adafruit/Adafruit-Metro-ESP32-P4-Hydra-PCB/factory-reset/README.md

# Coming soon - documentation in progress

## Factory Reset file - Metro ESP32-P4 Hydra - with 16 MB PSRAM - v1 Chipset

This is the factory reset file for the Metro ESP32-P4 Hydra - with 16 MB PSRAM - v1 Chipset.
