adafruit/Adafruit-Metro-ESP32-P4-Hydra-PCB/Adafruit_Metro_ESP32-P4_PrettyPins.pdf

## Power GND

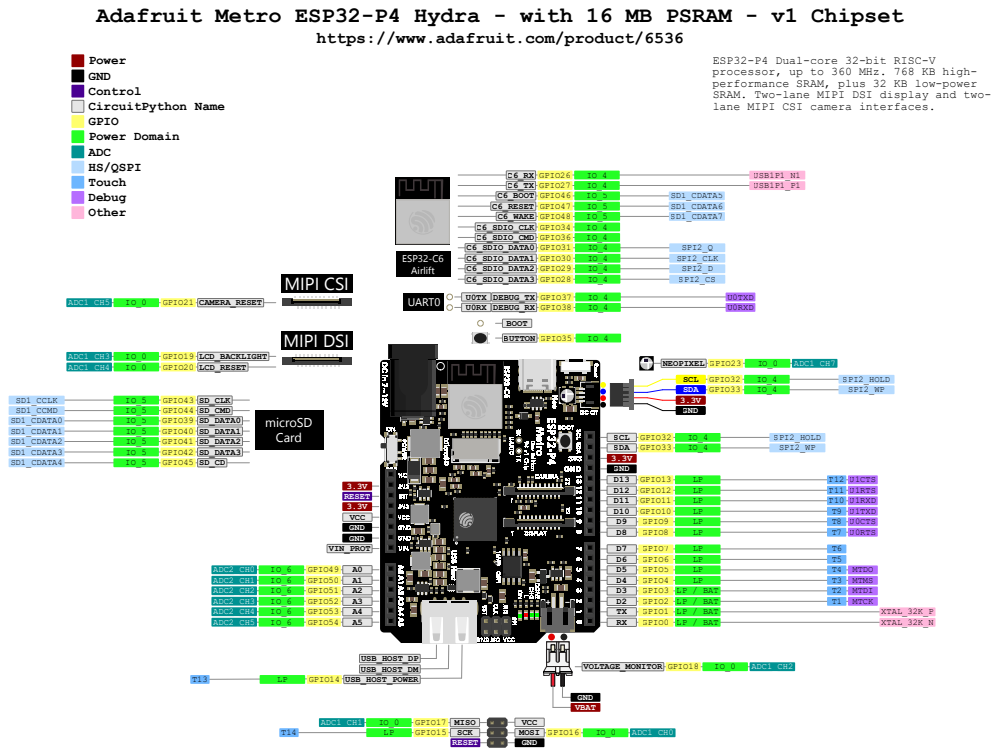
[picture p2: page 1]

Adafruit Metro ESP32-P4 Hydra - with 16 MB PSRAM - v1 Chipset

https://www.adafruit.com/product/6536

ESP32-P4 Dual-core 32-bit RISC-V
processor, up to 360 MHz. 768 KB high-
performance SRAM, plus 32 KB low-power
SRAM. Two-lane MIPI DSI display and two-
lane MIPI CSI camera interfaces.
