adafruit/Adafruit-Metro-ESP32-P4-Hydra-PCB/Adafruit Metro ESP32-P4 Hydra rev A.brd

## EAGLE design Adafruit Metro ESP32-P4 Hydra rev A.brd (2026-10-26)

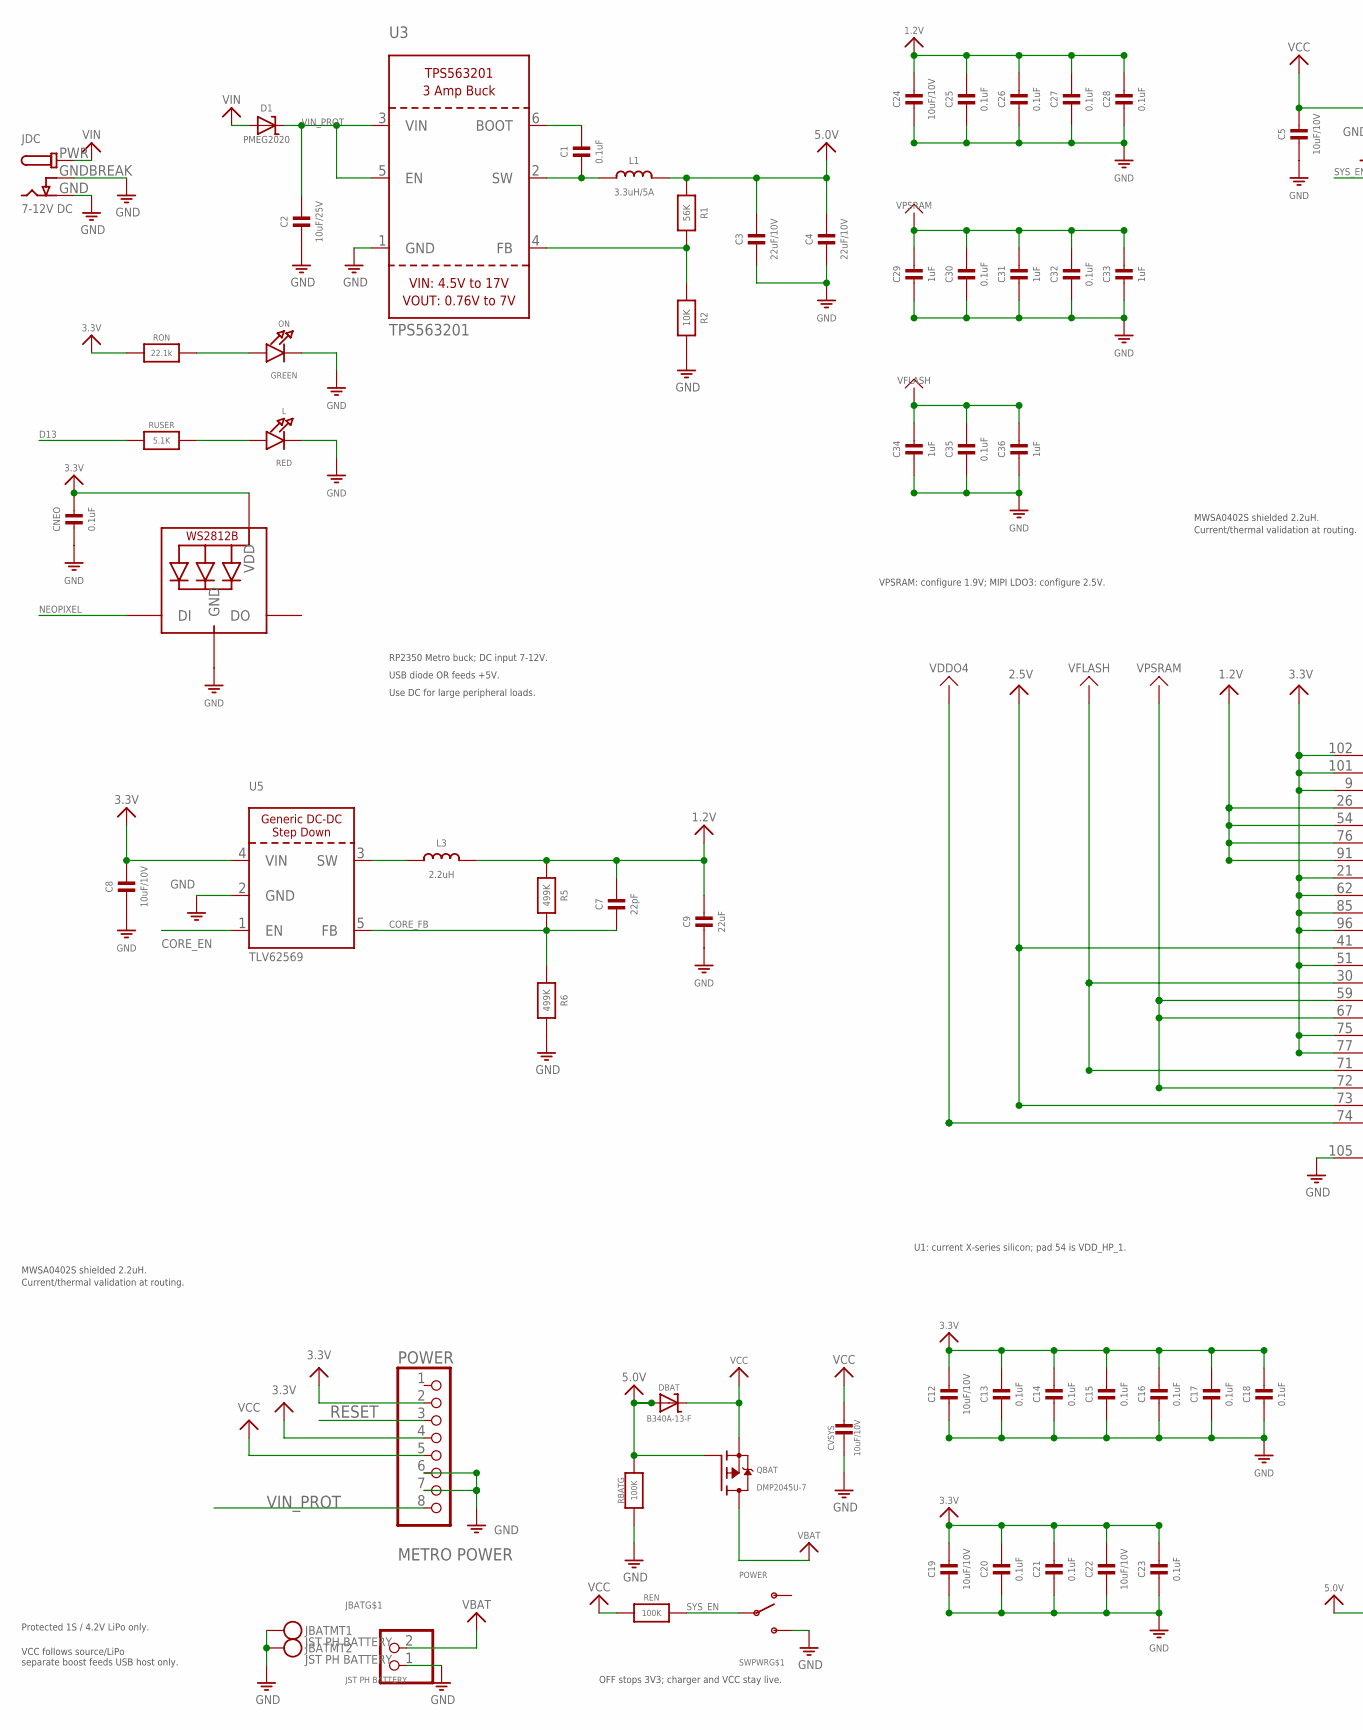
[picture p3: schematic Adafruit Metro ESP32-P4 Hydra rev A.sch, sheet 1, part in row 1, column 1]

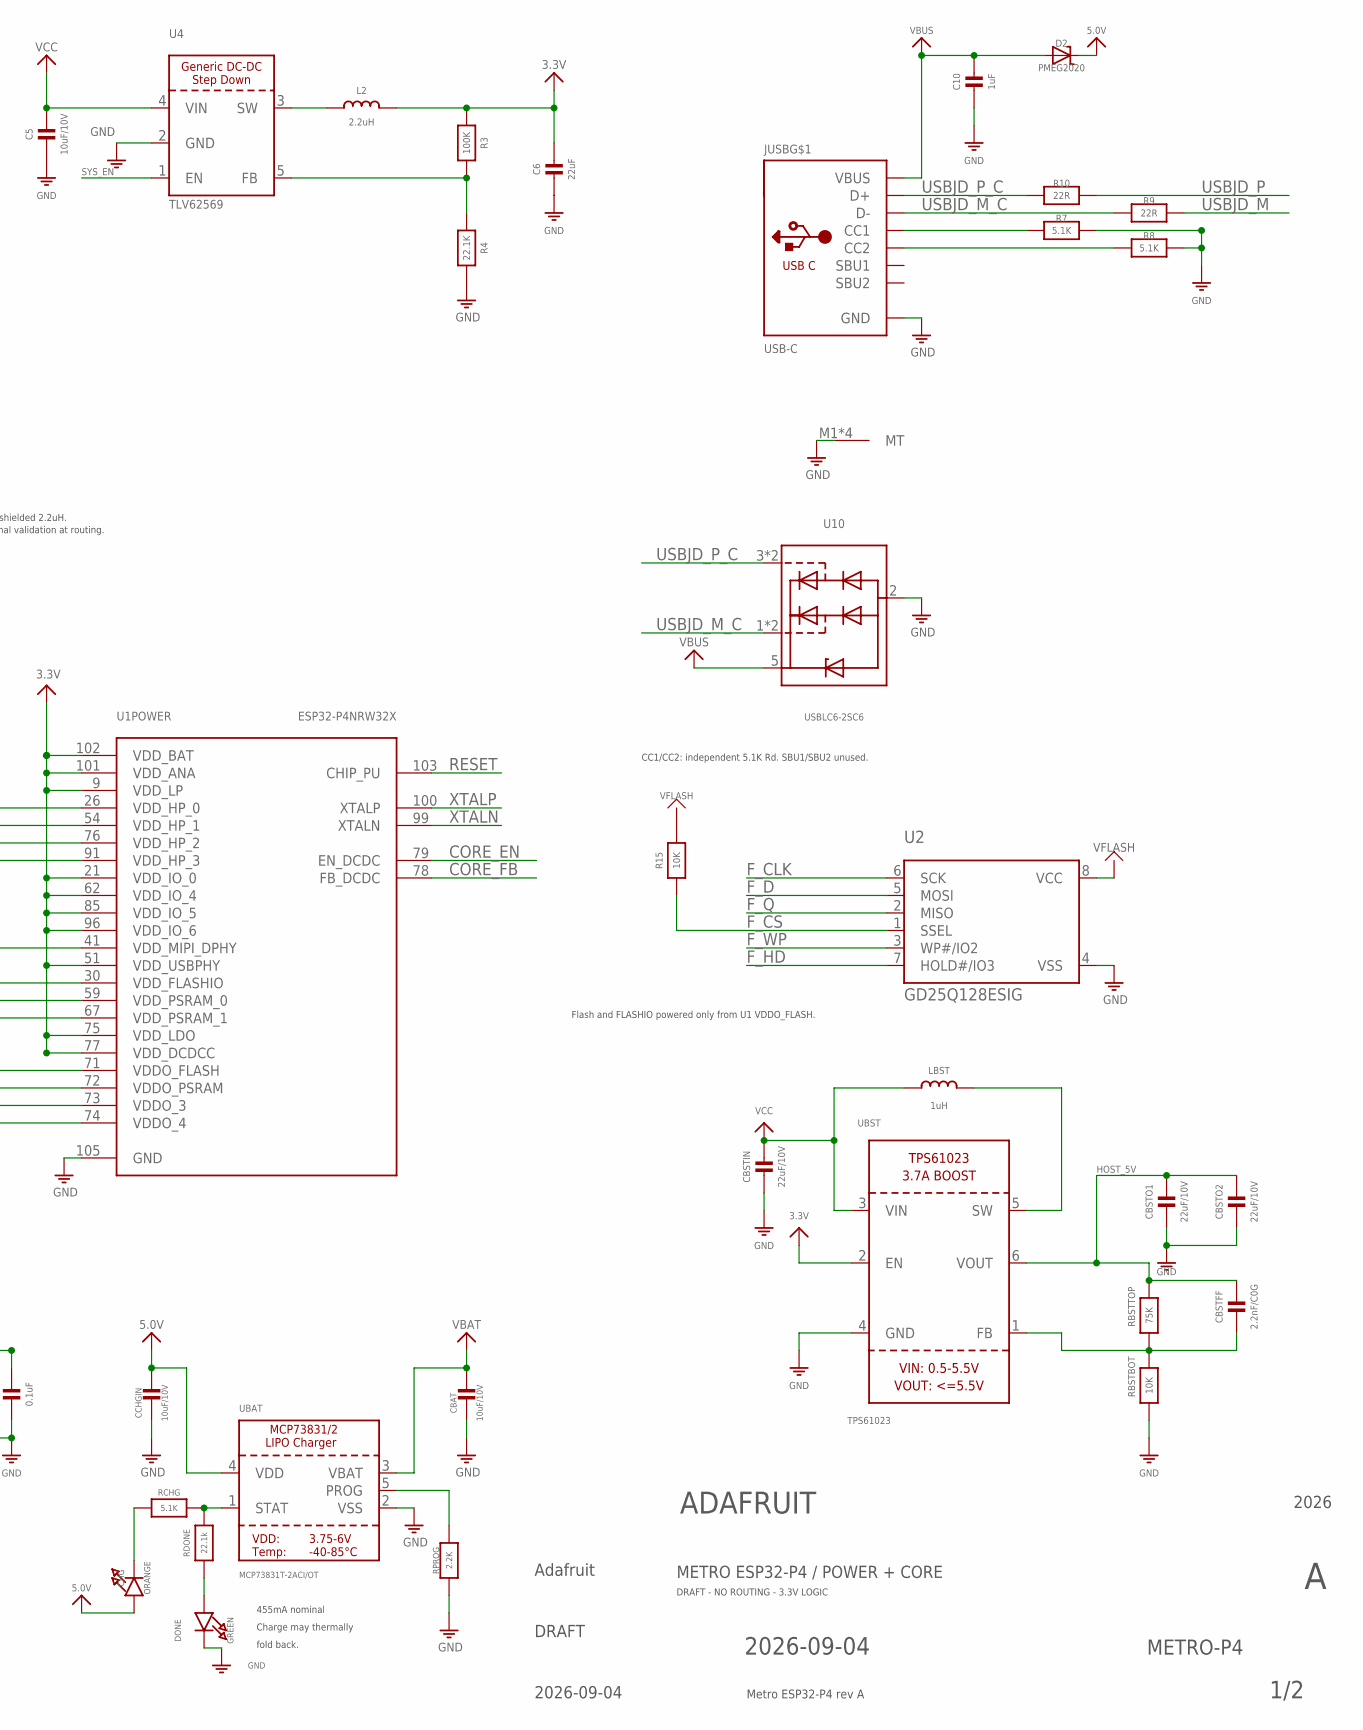
[picture p4: schematic Adafruit Metro ESP32-P4 Hydra rev A.sch, sheet 1, part in row 1, column 2]

Parts:
C1, C13, C14, C15, C16, C17, C18, C20, C21, C23, C25, C26, C27, C28, C30, C32, C35: 0.1uF; _0402NO
C2: 10uF/25V; 0805-NO
C3, C4: 22uF/10V; 0805-NO
C5, C8, C12, C19, C22, C24: 10uF/10V; 0805-NO
C6, C9: 22uF; 0805-NO
C7: 22pF; _0402NO
C10, C29, C31, C33, C34, C36: 1uF; 0603-NO
CBAT: 10uF/10V; 0805-NO
CBSTFF: 2.2nF/C0G; _0402NO; MPN GRM1555C1H222GA01D; LCSC C2987940
CBSTIN: 22uF/10V; 0805-NO; MPN CL21A226MPQNNNE; LCSC C29277
CBSTO1, CBSTO2: 22uF/10V; 0805-NO; MPN CL21A226MPQNNNE; LCSC C29277
CCHGIN: 10uF/10V; 0805-NO
CHG: ORANGE; CHIPLED_0603_NOOUTLINE
CNEO: 0.1uF; _0402NO
CVSYS: 10uF/10V; 0805-NO
D1, D2: PMEG2020; SOD-323
DBAT: B340A-13-F; SMADIODE; MPN B340A-13-F
DONE: GREEN; CHIPLED_0603_NOOUTLINE
HYDRA_ART: METRO-P4-HYDRA; METRO-P4-HYDRA-68.58X53.34
JBAT: JST PH BATTERY; JSTPH2_BATT
JDC: 7-12V DC; DCJACK_2MM_PTH
JUSB: USB-C; USB_C_CUSB31-CFM2AX-01-X
L: RED; CHIPLED_0603_NOOUTLINE
L1: 3.3uH/5A; INDUCTOR_0603S
L2, L3: 2.2uH; INDUCTOR_SUNLORD_MWSA0402S; MPN MWSA0402S-2R2MT; LCSC C408335
LBST: 1uH; INDUCTOR_5045_SMALLTABS
LED1: WS2812B_3535FULL; LED3535_FULLPADS
ON: GREEN; CHIPLED_0603_NOOUTLINE
POWER: METRO POWER; 1X08_OVALWAVE
QBAT: DMP2045U-7; SOT23-R; MPN DMP2045U-7
R1: 56K; _0402NO
R2, R15: 10K; _0402NO
R3: 100K; _0402NO
R4: 22.1K; _0402NO
R5, R6: 499K; _0402NO
R7, R8: 5.1K; _0402NO
R9, R10: 22R; _0402NO
RBATG: 100K; _0402NO
RBSTBOT: 10K; _0402NO
RBSTTOP: 75K; _0402NO
RCHG: 5.1K; _0402NO
RDONE: 22.1k; _0402NO
REN: 100K; _0402NO
RON: 22.1k; _0402NO
RPROG: 2.2K; _0402NO
RUSER: 5.1K; _0402NO
SWPWR: POWER; SPDT_SMT_SSSS811101
U1: ESP32-P4NRW32X; QFN104_10X10_P035_EP76; MPN ESP32-P4NRW32X; LCSC C9900140808
U2: GD25Q128ESIG; SOIC8_208MIL; MPN GD25Q128ESIG
U3: TPS563201; SOT23-6; MPN TPS563201DDCR
U4, U5: TLV62569; SOT23-5; MPN TLV62569DBVR
U10: USBLC6-2SC6; SOT23_6L_ST
UBAT: MCP73831T-2ACI/OT; SOT23-5
UBST: TPS61023; SOT563; MPN TPS61023DRLR; LCSC C919459

Connections:
1.2V: C7.1, C9.1, C24.1, C25.1, C26.1, C27.1, C28.1, L3.P$2 (2), R5.1, U1.26 (VDD_HP_0), U1.54 (VDD_HP_1), U1.76 (VDD_HP_2), U1.91 (VDD_HP_3)
2.5V: U1.41 (VDD_MIPI_DPHY), U1.73 (VDDO_3); also elsewhere on the board
3.3V: C6.1, C8.1, C12.1, C13.1, C14.1, C15.1, C16.1, C17.1, C18.1, C19.1, C20.1, C21.1, C22.1, C23.1, CNEO.1, L2.P$2 (2), LED1.2 (VDD), POWER.2, POWER.4, R3.1, RON.1, U1.9 (VDD_LP), U1.21 (VDD_IO_0), U1.51 (VDD_USBPHY), U1.62 (VDD_IO_4), U1.75 (VDD_LDO), U1.77 (VDD_DCDCC), U1.85 (VDD_IO_5), U1.96 (VDD_IO_6), U1.101 (VDD_ANA), U1.102 (VDD_BAT), U5.4 (VIN), UBST.2 (EN); also elsewhere on the board
5.0V: C3.1, C4.1, CCHGIN.1, CHG.A, D2.C, DBAT.A, L1.P$2 (2), QBAT.1 (G), R1.1, RBATG.1, UBAT.4 (VDD)
BAT_LED: CHG.C, RCHG.1
BAT_PROG: RPROG.1, UBAT.5 (PROG)
BAT_STAT: RCHG.2, RDONE.1, UBAT.1 (STAT)
BST_FB: CBSTFF.2, RBSTBOT.1, RBSTTOP.2, UBST.1 (FB)
BST_SW: LBST.2, UBST.5 (SW)
BUCK5_BST: C1.1, U3.6 (BOOT)
BUCK5_FB: R1.2, R2.1, U3.4 (FB)
BUCK5_SW: C1.2, L1.P$1 (1), U3.2 (SW)
CORE_EN: U1.79 (EN_DCDC), U5.1 (EN)
CORE_FB: C7.2, R5.2, R6.1, U1.78 (FB_DCDC), U5.5 (FB)
D13: RUSER.1; also elsewhere on the board
DONE_LED: DONE.A, RDONE.2
F_CLK: U2.6 (SCK); also elsewhere on the board
F_CS: R15.2, U2.1 (SSEL); also elsewhere on the board
F_D: U2.5 (MOSI); also elsewhere on the board
F_HD: U2.7 (HOLD#/IO3); also elsewhere on the board
F_Q: U2.2 (MISO); also elsewhere on the board
F_WP: U2.3 (WP#/IO2); also elsewhere on the board
GND: C2.2, C3.2, C4.2, C5.2, C6.2, C8.2, C9.2, C10.2, C12.2, C13.2, C14.2, C15.2, C16.2, C17.2, C18.2, C19.2, C20.2, C21.2, C22.2, C23.2, C24.2, C25.2, C26.2, C27.2, C28.2, C29.2, C30.2, C31.2, C32.2, C33.2, C34.2, C35.2, C36.2, CBAT.2, CBSTIN.2, CBSTO1.2, CBSTO2.2, CCHGIN.2, CNEO.2, CVSYS.2, DONE.C, JBAT.1, JBAT.NC1, JBAT.NC2, JDC.GND, JDC.GNDBREAK, JUSB.A1B12 (GND), JUSB.B1A12 (GND), JUSB.M1 (MT), JUSB.M2 (MT), JUSB.M3 (MT), JUSB.M4 (MT), L.C, LED1.4 (GND), ON.C, POWER.6, POWER.7, R2.2, R4.2, R6.2, R7.2, R8.2, RBATG.2, RBSTBOT.2, RPROG.2, SWPWR.C (S), U1.105 (GND), U2.4 (VSS), U3.1 (GND), U4.2 (GND), U5.2 (GND), U10.2 (GND), UBAT.2 (VSS), UBST.4 (GND); also elsewhere on the board
HOST_5V: CBSTFF.1, CBSTO1.1, CBSTO2.1, RBSTTOP.1, UBST.6 (VOUT); also elsewhere on the board
JUSBCC1: JUSB.A5 (CC1), R7.1
JUSBCC2: JUSB.B5 (CC2), R8.1
LED_ON: ON.A, RON.2
LED_USER: L.A, RUSER.2
NEOPIXEL: LED1.1 (DI); also elsewhere on the board
RESET: POWER.3, U1.103 (CHIP_PU); also elsewhere on the board
SYS_EN: REN.2, SWPWR.B, U4.1 (EN)
U4_FB: R3.2, R4.1, U4.5 (FB)
U4_SW: L2.P$1 (1), U4.3 (SW)
U5_SW: L3.P$1 (1), U5.3 (SW)
USBJD_M: R9.2; also elsewhere on the board
USBJD_M_C: JUSB.A7 (D-), JUSB.B7 (D-), R9.1, U10.1 (IO1), U10.6 (IO1)
USBJD_P: R10.2; also elsewhere on the board
USBJD_P_C: JUSB.A6 (D+), JUSB.B6 (D+), R10.1, U10.3 (IO2), U10.4 (IO2)
VBAT: CBAT.1, JBAT.2, QBAT.3 (D), UBAT.3 (VBAT); also elsewhere on the board
VBUS: C10.1, D2.A, JUSB.A4B9 (VBUS), JUSB.B4A9 (VBUS), U10.5 (VCC)
VCC: C5.1, CBSTIN.1, CVSYS.1, DBAT.C, LBST.1, POWER.5, QBAT.2 (S), REN.1, U4.4 (VIN), UBST.3 (VIN); also elsewhere on the board
VDDO4: U1.74 (VDDO_4); also elsewhere on the board
VFLASH: C34.1, C35.1, C36.1, R15.1, U1.30 (VDD_FLASHIO), U1.71 (VDDO_FLASH), U2.8 (VCC)
VIN: D1.A, JDC.PWR
VIN_PROT: C2.1, D1.C, POWER.8, U3.3 (VIN), U3.5 (EN)
VPSRAM: C29.1, C30.1, C31.1, C32.1, C33.1, U1.59 (VDD_PSRAM_0), U1.67 (VDD_PSRAM_1), U1.72 (VDDO_PSRAM)
XTALN: U1.99 (XTALN); also elsewhere on the board
XTALP: U1.100 (XTALP); also elsewhere on the board

Notes on the sheet:
1/2
Metro ESP32-P4 rev A
2026-09-04
2026
ADAFRUIT
Adafruit
DRAFT
METRO-P4
METRO ESP32-P4 / POWER + CORE
DRAFT - NO ROUTING - 3.3V LOGIC
RP2350 Metro buck; DC input 7-12V.
USB diode OR feeds +5V.
MWSA0402S shielded 2.2uH.
Current/thermal validation at routing.
CC1/CC2: independent 5.1K Rd. SBU1/SBU2 unused.
U1: current X-series silicon; pad 54 is VDD_HP_1.
VPSRAM: configure 1.9V; MIPI LDO3: configure 2.5V.
Flash and FLASHIO powered only from U1 VDDO_FLASH.
455mA nominal
OFF stops 3V3; charger and VCC stay live.
Protected 1S / 4.2V LiPo only.
VCC follows source/LiPo separate boost feeds USB host only.
Use DC for large peripheral loads.
Charge may thermally
fold back.

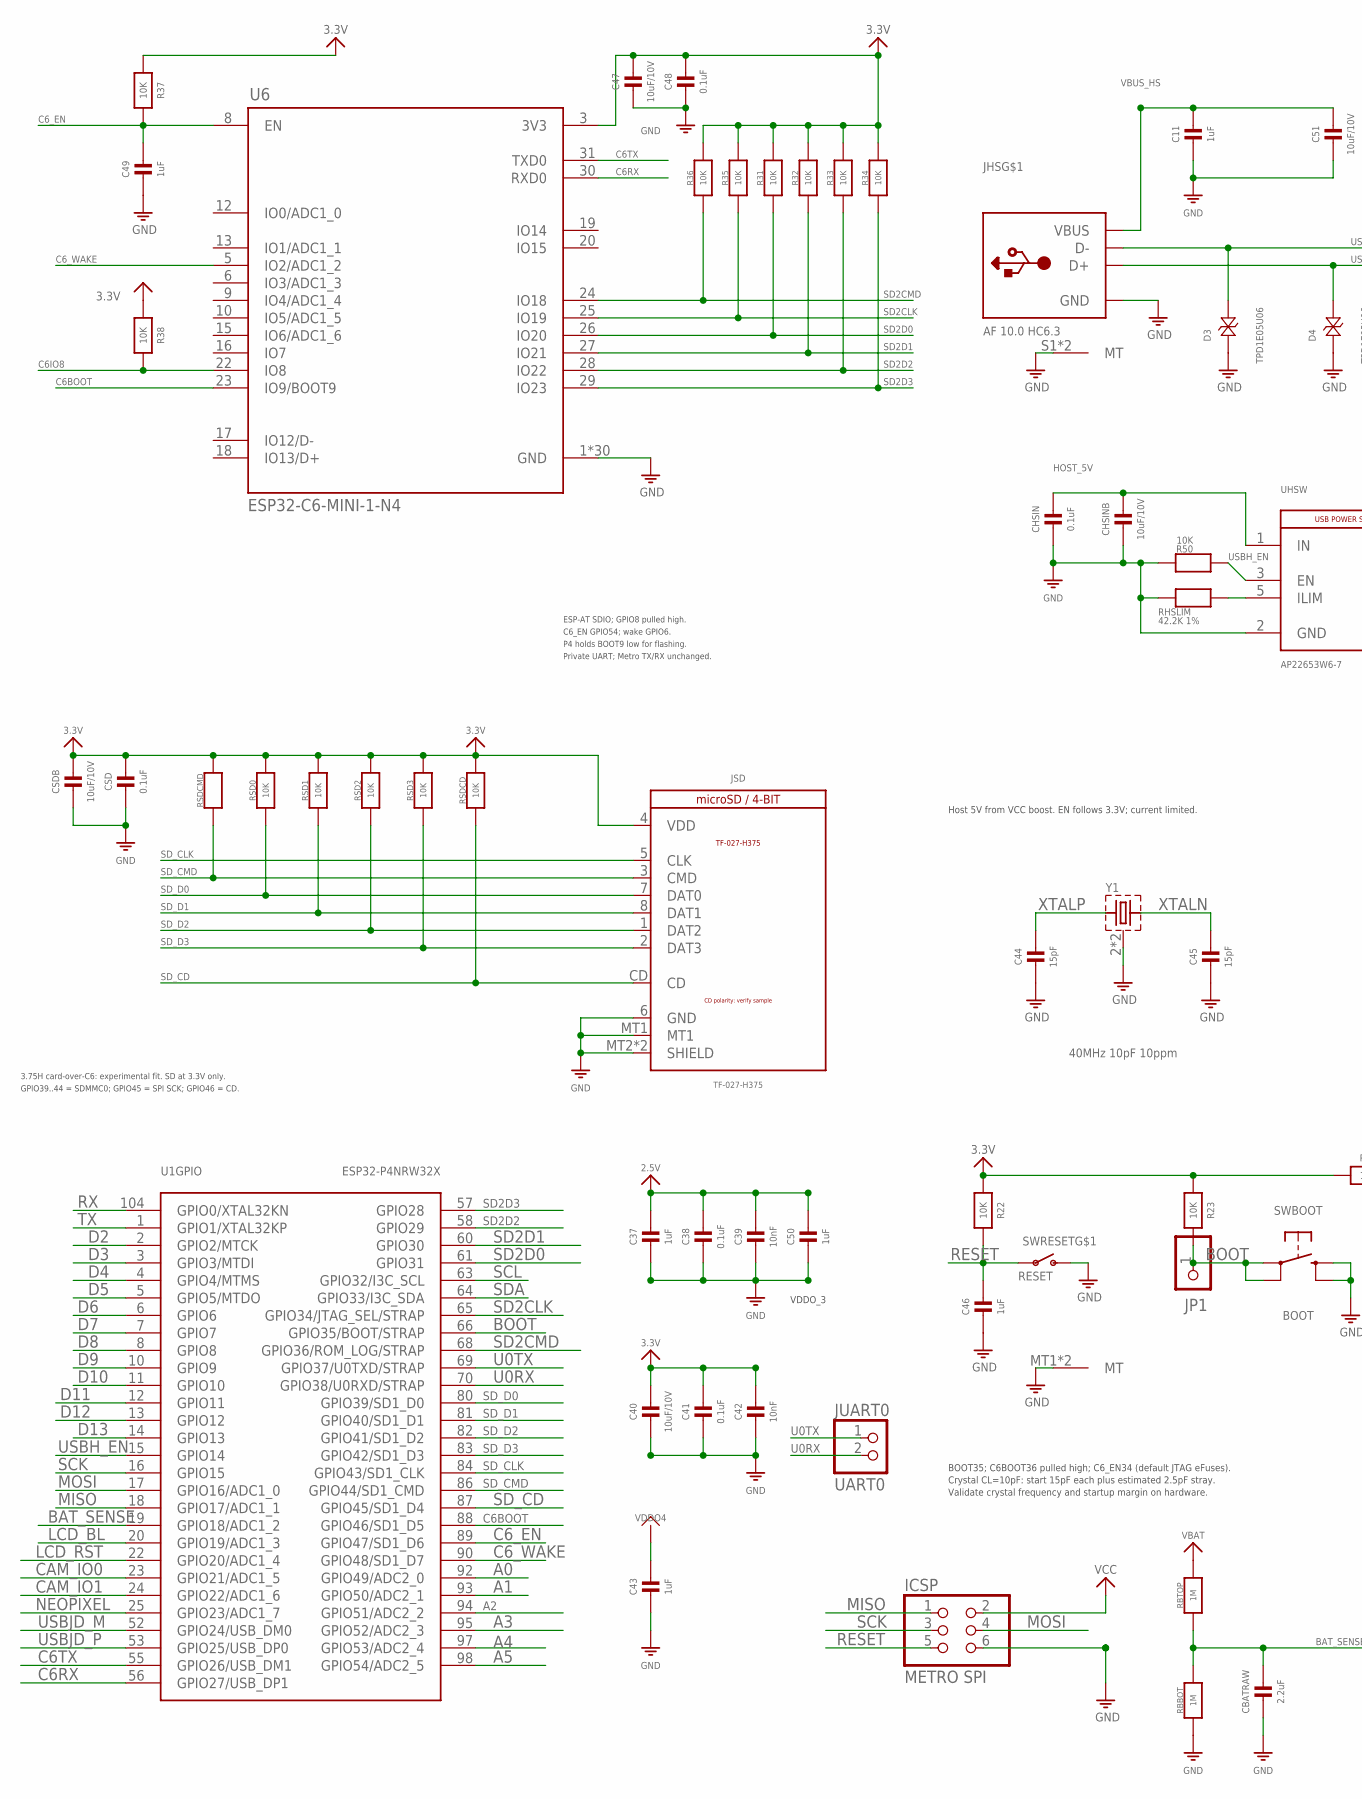
[picture p5: schematic Adafruit Metro ESP32-P4 Hydra rev A.sch, sheet 2, part in row 1, column 1]

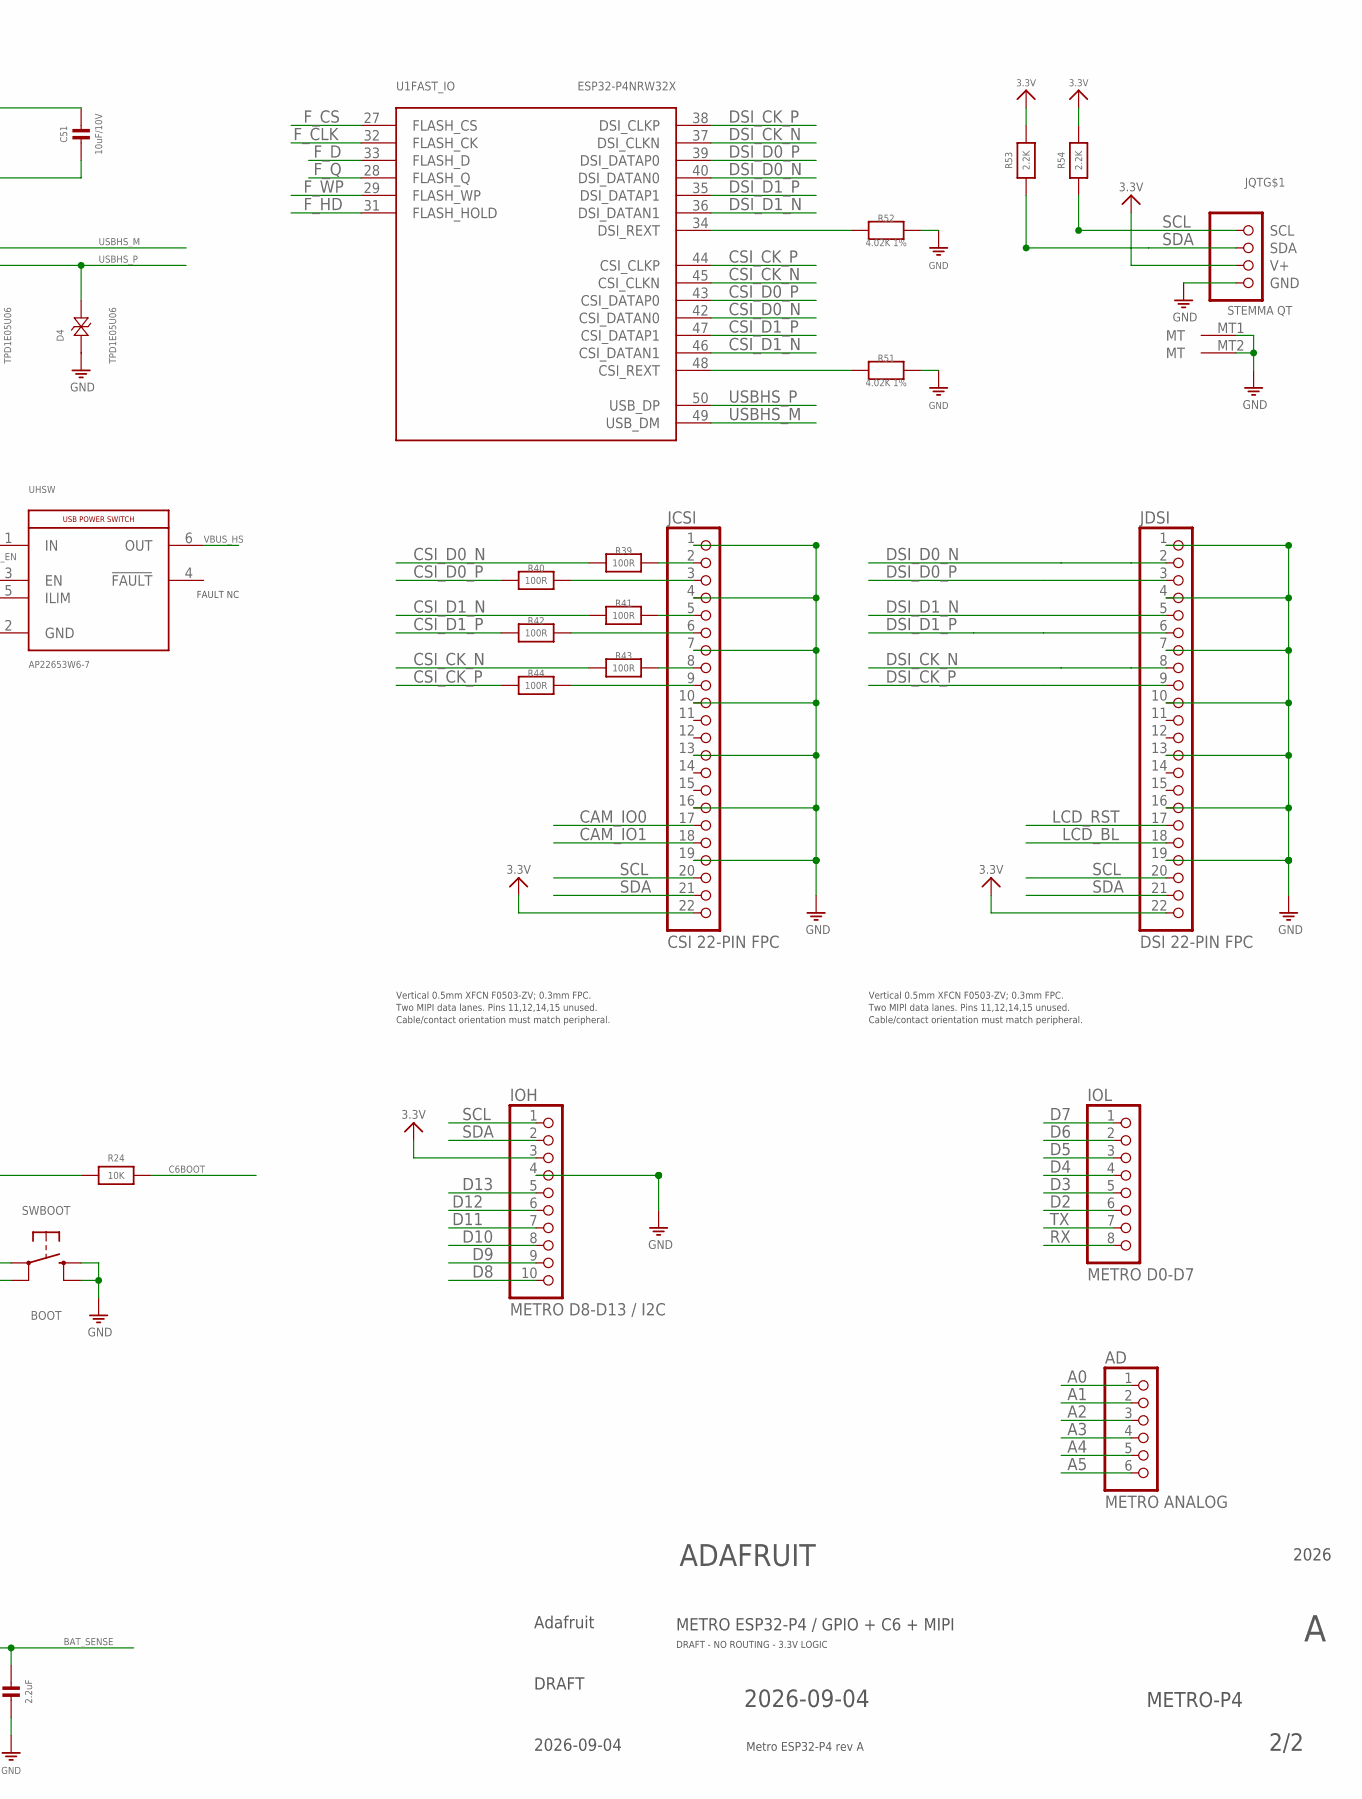
[picture p6: schematic Adafruit Metro ESP32-P4 Hydra rev A.sch, sheet 2, part in row 1, column 2]

Parts:
AD: METRO ANALOG; 1X06_OVALWAVE
C11, C37, C43, C46, C49, C50: 1uF; 0603-NO
C38, C41, C48: 0.1uF; _0402NO
C39, C42: 10nF; _0402NO
C40, C47, C51: 10uF/10V; 0805-NO
C44, C45: 15pF; _0402NO
CBATRAW: 2.2uF; 0805-NO
CHSIN: 0.1uF; _0402NO
CHSINB: 10uF/10V; 0805-NO
CSD: 0.1uF; _0402NO
CSDB: 10uF/10V; 0805-NO
D3, D4: TPD1E05U06; SOD-523; MPN TPD1E05U06DYAR
ICSP: METRO SPI; 2X03_ROUND_70MIL
IOH: METRO D8-D13 / I2C; 1X10_OVALWAVE
IOL: METRO D0-D7; 1X08_OVALWAVE
JCSI: CSI 22-PIN FPC; FPC_22PIN_0.5MM_VERT_F0503_ZV; MPN F0503-ZV-22-20T-R; LCSC C481245
JDSI: DSI 22-PIN FPC; FPC_22PIN_0.5MM_VERT_F0503_ZV; MPN F0503-ZV-22-20T-R; LCSC C481245
JHS: AF 10.0 HC6.3; USB_TYPE_A_THM_SHORT; MPN AF 10.0 HC6.3; LCSC C456017
JP1: HEADER-1X1ROUND; 1X01_ROUND
JQT: STEMMA QT; JST_SH4
JSD: TF-027-H375; HANBO_TF_027_H375; MPN TF-027-H375; LCSC C22374618
JUART0: UART0; 1X02_ROUND
R22, R23, R24, R31, R32, R33, R34, R35, R36, R37, R38, R50: 10K; _0402NO
R39, R40, R41, R42, R43, R44: 100R; _0402NO
R51, R52: 4.02K 1%; _0402NO
R53, R54: 2.2K; _0402NO
RBBOT: 1M; _0402NO
RBTOP: 1M; _0402NO
RHSLIM: 42.2K 1%; _0402NO
RSD0, RSD1, RSD2, RSD3: 10K; _0402NO
RSDCD: 10K; _0402NO
RSDCMD: 10K; _0402NO
SWBOOT: BOOT; BTN_RKB2_4.6X2.8; MPN GT-TC048D-H025-L1; LCSC C843674
SWRESET: RESET; SPST_TACTILE_RA
U1: ESP32-P4NRW32X; QFN104_10X10_P035_EP76; MPN ESP32-P4NRW32X; LCSC C9900140808
U6: ESP32-C6-MINI-1-N4; ESP32-PICO-MINI; MPN ESP32-C6-MINI-1-N4
UHSW: AP22653W6-7; SOT26_TYPE_A1_DIODES; MPN AP22653W6-7; LCSC C2158037
Y1: 40MHz 10pF 10ppm; CRYSTAL_2X1.6; MPN ECS-400-10-37B-CKY-TR3

Connections:
2.5V: C37.1, C38.1, C39.1, C50.1; also elsewhere on the board
3.3V: C40.1, C41.1, C42.1, C47.1, C48.1, CSD.1, CSDB.1, IOH.3, JCSI.22, JDSI.22, JQT.2 (V+), JSD.4 (VDD), R22.1, R23.1, R24.1, R31.1, R32.1, R33.1, R34.1, R35.1, R36.1, R37.1, R38.1, R53.1, R54.1, RSD0.1, RSD1.1, RSD2.1, RSD3.1, RSDCD.1, RSDCMD.1, U6.3 (3V3); also elsewhere on the board
A0: AD.1, U1.92 (GPIO49/ADC2_0)
A1: AD.2, U1.93 (GPIO50/ADC2_1)
A2: AD.3, U1.94 (GPIO51/ADC2_2)
A3: AD.4, U1.95 (GPIO52/ADC2_3)
A4: AD.5, U1.97 (GPIO53/ADC2_4)
A5: AD.6, U1.98 (GPIO54/ADC2_5)
BAT_SENSE: CBATRAW.1, RBBOT.1, RBTOP.2, U1.19 (GPIO18/ADC1_2)
BOOT: JP1.1, R23.2, SWBOOT.A, SWBOOT.A' (P1), U1.66 (GPIO35/BOOT/STRAP)
C6BOOT: R24.2, U1.88 (GPIO46/SD1_D5), U6.23 (IO9/BOOT9)
C6IO8: R38.2, U6.22 (IO8)
C6RX: U1.56 (GPIO27/USB_DP1), U6.30 (RXD0)
C6TX: U1.55 (GPIO26/USB_DM1), U6.31 (TXD0)
C6_EN: C49.1, R37.2, U1.89 (GPIO47/SD1_D6), U6.8 (EN)
C6_WAKE: U1.90 (GPIO48/SD1_D7), U6.5 (IO2/ADC1_2)
CAM_IO0: JCSI.17, U1.23 (GPIO21/ADC1_5)
CAM_IO1: JCSI.18, U1.24 (GPIO22/ADC1_6)
CSI_CK_C_N: JCSI.8, R43.2
CSI_CK_C_P: JCSI.9, R44.2
CSI_CK_N: R43.1, U1.45 (CSI_CLKN)
CSI_CK_P: R44.1, U1.44 (CSI_CLKP)
CSI_D0_C_N: JCSI.2, R39.2
CSI_D0_C_P: JCSI.3, R40.2
CSI_D0_N: R39.1, U1.42 (CSI_DATAN0)
CSI_D0_P: R40.1, U1.43 (CSI_DATAP0)
CSI_D1_C_N: JCSI.5, R41.2
CSI_D1_C_P: JCSI.6, R42.2
CSI_D1_N: R41.1, U1.46 (CSI_DATAN1)
CSI_D1_P: R42.1, U1.47 (CSI_DATAP1)
CSI_EXT: R51.1, U1.48 (CSI_REXT)
D2: IOL.6, U1.2 (GPIO2/MTCK)
D3: IOL.5, U1.3 (GPIO3/MTDI)
D4: IOL.4, U1.4 (GPIO4/MTMS)
D5: IOL.3, U1.5 (GPIO5/MTDO)
D6: IOL.2, U1.6 (GPIO6)
D7: IOL.1, U1.7 (GPIO7)
D8: IOH.10, U1.8 (GPIO8)
D9: IOH.9, U1.10 (GPIO9)
D10: IOH.8, U1.11 (GPIO10)
D11: IOH.7, U1.12 (GPIO11)
D12: IOH.6, U1.13 (GPIO12)
D13: IOH.5, U1.14 (GPIO13); also elsewhere on the board
DSI_CK_N: JDSI.8, U1.37 (DSI_CLKN)
DSI_CK_P: JDSI.9, U1.38 (DSI_CLKP)
DSI_D0_N: JDSI.2, U1.40 (DSI_DATAN0)
DSI_D0_P: JDSI.3, U1.39 (DSI_DATAP0)
DSI_D1_N: JDSI.5, U1.36 (DSI_DATAN1)
DSI_D1_P: JDSI.6, U1.35 (DSI_DATAP1)
DSI_EXT: R52.1, U1.34 (DSI_REXT)
F_CLK: U1.32 (FLASH_CK); also elsewhere on the board
F_CS: U1.27 (FLASH_CS); also elsewhere on the board
F_D: U1.33 (FLASH_D); also elsewhere on the board
F_HD: U1.31 (FLASH_HOLD); also elsewhere on the board
F_Q: U1.28 (FLASH_Q); also elsewhere on the board
F_WP: U1.29 (FLASH_WP); also elsewhere on the board
GND: C11.2, C37.2, C38.2, C39.2, C40.2, C41.2, C42.2, C43.2, C44.2, C45.2, C46.2, C47.2, C48.2, C49.2, C50.2, C51.2, CBATRAW.2, CHSIN.2, CHSINB.2, CSD.2, CSDB.2, D3.A, D4.A, ICSP.6, IOH.4, JCSI.1, JCSI.4, JCSI.7, JCSI.10, JCSI.13, JCSI.16, JCSI.19, JDSI.1, JDSI.4, JDSI.7, JDSI.10, JDSI.13, JDSI.16, JDSI.19, JHS.GND, JHS.S1 (MT), JHS.S2 (MT), JQT.1 (GND), JQT.MT1 (MT), JQT.MT2 (MT), JSD.6 (GND), JSD.MT1, JSD.MT2 (SHIELD), JSD.MT3 (SHIELD), R50.2, R51.2, R52.2, RBBOT.2, RHSLIM.1, SWBOOT.B (S), SWBOOT.B' (S1), SWRESET.2 (S), SWRESET.MT1 (MT), SWRESET.MT2 (MT), U6.1 (GND), U6.2 (GND), U6.11 (GND), U6.14 (GND), U6.36 (GND), U6.37 (GND), U6.38 (GND), U6.39 (GND), U6.40 (GND), U6.41 (GND), U6.42 (GND), U6.43 (GND), U6.44 (GND), U6.45 (GND), U6.46 (GND), U6.47 (GND), U6.48 (GND), U6.49 (GND), U6.50 (GND), U6.51 (GND), U6.52 (GND), U6.53 (GND), U6.54 (GND), U6.55 (GND), U6.56 (GND), U6.57 (GND), U6.58 (GND), U6.59 (GND), U6.60 (GND), U6.61 (GND), UHSW.2 (GND), Y1.2 (GND), Y1.4 (GND); also elsewhere on the board
HOST_5V: CHSIN.1, CHSINB.1, UHSW.1 (IN); also elsewhere on the board
HOST_ILIM: RHSLIM.2, UHSW.5 (ILIM)
LCD_BL: JDSI.18, U1.20 (GPIO19/ADC1_3)
LCD_RST: JDSI.17, U1.22 (GPIO20/ADC1_4)
MISO: ICSP.1, U1.18 (GPIO17/ADC1_1)
MOSI: ICSP.4, U1.17 (GPIO16/ADC1_0)
NEOPIXEL: U1.25 (GPIO23/ADC1_7); also elsewhere on the board
RESET: C46.1, ICSP.5, R22.2, SWRESET.1; also elsewhere on the board
RX: IOL.8, U1.104 (GPIO0/XTAL32KN)
SCK: ICSP.3, U1.16 (GPIO15)
SCL: IOH.1, JCSI.20, JDSI.20, JQT.4 (SCL), R54.2, U1.63 (GPIO32/I3C_SCL)
SD2CLK: R35.2, U1.65 (GPIO34/JTAG_SEL/STRAP), U6.25 (IO19)
SD2CMD: R36.2, U1.68 (GPIO36/ROM_LOG/STRAP), U6.24 (IO18)
SD2D0: R31.2, U1.61 (GPIO31), U6.26 (IO20)
SD2D1: R32.2, U1.60 (GPIO30), U6.27 (IO21)
SD2D2: R33.2, U1.58 (GPIO29), U6.28 (IO22)
SD2D3: R34.2, U1.57 (GPIO28), U6.29 (IO23)
SDA: IOH.2, JCSI.21, JDSI.21, JQT.3 (SDA), R53.2, U1.64 (GPIO33/I3C_SDA)
SD_CD: JSD.CD, RSDCD.2, U1.87 (GPIO45/SD1_D4)
SD_CLK: JSD.5 (CLK), U1.84 (GPIO43/SD1_CLK)
SD_CMD: JSD.3 (CMD), RSDCMD.2, U1.86 (GPIO44/SD1_CMD)
SD_D0: JSD.7 (DAT0), RSD0.2, U1.80 (GPIO39/SD1_D0)
SD_D1: JSD.8 (DAT1), RSD1.2, U1.81 (GPIO40/SD1_D1)
SD_D2: JSD.1 (DAT2), RSD2.2, U1.82 (GPIO41/SD1_D2)
SD_D3: JSD.2 (DAT3), RSD3.2, U1.83 (GPIO42/SD1_D3)
TX: IOL.7, U1.1 (GPIO1/XTAL32KP)
U0RX: JUART0.2, U1.70 (GPIO38/U0RXD/STRAP)
U0TX: JUART0.1, U1.69 (GPIO37/U0TXD/STRAP)
USBHS_M: D3.K (C), JHS.D-, U1.49 (USB_DM)
USBHS_P: D4.K (C), JHS.D+, U1.50 (USB_DP)
USBH_EN: R50.1, U1.15 (GPIO14), UHSW.3 (EN)
USBJD_M: U1.52 (GPIO24/USB_DM0); also elsewhere on the board
USBJD_P: U1.53 (GPIO25/USB_DP0); also elsewhere on the board
VBAT: RBTOP.1; also elsewhere on the board
VBUS_HS: C11.1, C51.1, JHS.VBUS, UHSW.6 (OUT)
VCC: ICSP.2; also elsewhere on the board
VDDO4: C43.1; also elsewhere on the board
XTALN: C45.1, Y1.3 (2); also elsewhere on the board
XTALP: C44.1, Y1.1; also elsewhere on the board

Notes on the sheet:
2/2
Metro ESP32-P4 rev A
2026-09-04
2026
ADAFRUIT
Adafruit
DRAFT
METRO-P4
METRO ESP32-P4 / GPIO + C6 + MIPI
DRAFT - NO ROUTING - 3.3V LOGIC
Host 5V from VCC boost. EN follows 3.3V; current limited.
BOOT35; C6BOOT36 pulled high; C6_EN34 (default JTAG eFuses).
Crystal CL=10pF: start 15pF each plus estimated 2.5pF stray.
Validate crystal frequency and startup margin on hardware.
ESP-AT SDIO; GPIO8 pulled high.
C6_EN GPIO54; wake GPIO6.
P4 holds BOOT9 low for flashing.
Private UART; Metro TX/RX unchanged.
Vertical 0.5mm XFCN F0503-ZV; 0.3mm FPC.
Two MIPI data lanes. Pins 11,12,14,15 unused.
Cable/contact orientation must match peripheral.
VDDO_3
FAULT NC
3.75H card-over-C6: experimental fit. SD at 3.3V only.
GPIO39..44 = SDMMC0; GPIO45 = SPI SCK; GPIO46 = CD.

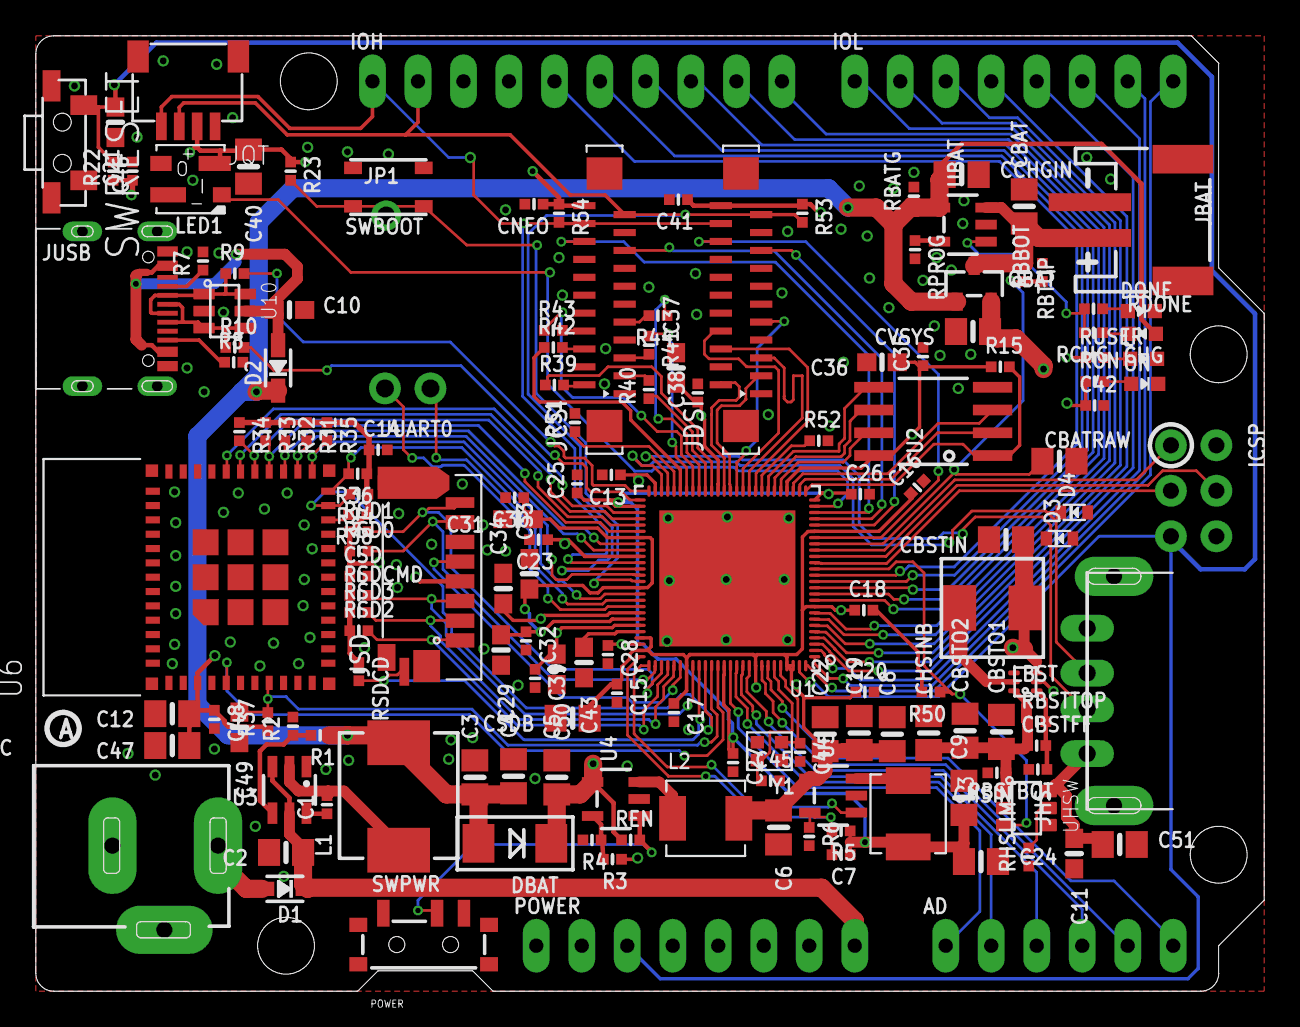
[picture p7: board Adafruit Metro ESP32-P4 Hydra rev A.brd from above]

Board: 4 copper layers, 68.6 x 53.3 mm, 227 parts (1 on the bottom side), 124 nets.

Other parts of the board:
PLABEL0, PLABEL59: PLABEL0
PLABEL1: PLABEL1
PLABEL2: PLABEL2
PLABEL3, PLABEL5: PLABEL3
PLABEL4, PLABEL31: PLABEL4
PLABEL6, PLABEL28: PLABEL6
PLABEL7, PLABEL8, PLABEL32: PLABEL7
PLABEL9: PLABEL9
PLABEL10: PLABEL10
PLABEL11: PLABEL11
PLABEL12: PLABEL12
PLABEL13: PLABEL13
PLABEL14: PLABEL14
PLABEL15: PLABEL15
PLABEL16: PLABEL16
PLABEL17: PLABEL17
PLABEL18: PLABEL18
PLABEL19: PLABEL19
PLABEL20: PLABEL20
PLABEL21: PLABEL21
PLABEL22: PLABEL22
PLABEL23: PLABEL23
PLABEL24: PLABEL24
PLABEL25: PLABEL25
PLABEL26: PLABEL26
PLABEL27: PLABEL27
PLABEL29: PLABEL29
PLABEL30: PLABEL30
PLABEL33: PLABEL33
PLABEL34: PLABEL34
PLABEL35, PLABEL38: PLABEL35
PLABEL36, PLABEL39: PLABEL36
PLABEL37: PLABEL37
PLABEL40: PLABEL40
PLABEL41: PLABEL41
PLABEL42: PLABEL42
PLABEL43: PLABEL43
PLABEL44: PLABEL44
PLABEL45: PLABEL45
PLABEL46: PLABEL46
PLABEL47: PLABEL47
PLABEL48: PLABEL48
PLABEL49: PLABEL49
PLABEL50: PLABEL50
PLABEL51: PLABEL51
PLABEL52: PLABEL52
PLABEL53: PLABEL53
PLABEL54: PLABEL54
PLABEL55: PLABEL55
PLABEL56: PLABEL56
PLABEL57: PLABEL57
PLABEL58: PLABEL58
PLABEL60: PLABEL60
PLABEL61: PLABEL61
PLABEL62: PLABEL62
PLABEL63: PLABEL63
PLABEL64: PLABEL64
PLABEL65: PLABEL65
U$1: PCBFEAT-REV-040
