adafruit/Adafruit-Metro-ESP32-P4-Hydra-PCB/(notices)

Notices in the files:
parts and their libraries:
adafruit_wireless: Footprint geometry cross-checked against Espressif kicad-libraries revision dd76561812ab300351234ba6e0ec1295641796f0 (CC-BY-SA-4.0 with design-output exception).
